steelead/Capstone-Intel-Mood-Light/Project Plan/Team16 project plan.pdf

ID | Task
Mode
Task Name | Duration | Start | Finish | Predecessors | Resource Names
1 | Project Proposal | 10 days | Mon 1/4/16 | Fri 1/15/16
2 | choosing the weight

## sensor

7 days | Sun 1/10/16 | Sun 1/17/16
3 | Buying the parts | 5 days | Mon 1/18/16Fri 1/22/16 | 2
4 | Testing the parts | 0 days | Sat 1/23/16 | Sat 1/23/16 | 3
5 | Interfacing LED's strip

## with arduinu

7 days | Sun 1/31/16 | Sat 2/6/16
6 | - Modify LED strip

## remote to be controlled using arduino

7 days | Sun 2/7/16 | Sat 2/13/16 | 4
7 | Interface pressure

## sensor with arduino

7 days | Sun 2/14/16 | Sat 2/20/16 | 6
8 | - Modify weight

## sensor into a surface the user’s body

7 days | Sun 2/21/16 | Sat 2/27/16 | 7
9 | Code for user

## interface

7 days | Sun 2/28/16 | Sat 3/5/16 | 8
10 | First draft of schematic

## and layout

1 day | Sun 3/6/16 | Sun 3/6/16
11 | Revision of the

## schematic

1 day | Mon 3/7/16 | Mon 3/7/16 | 9
F | S | T | T | S
Jan 3, '16 | Jan 10, '16

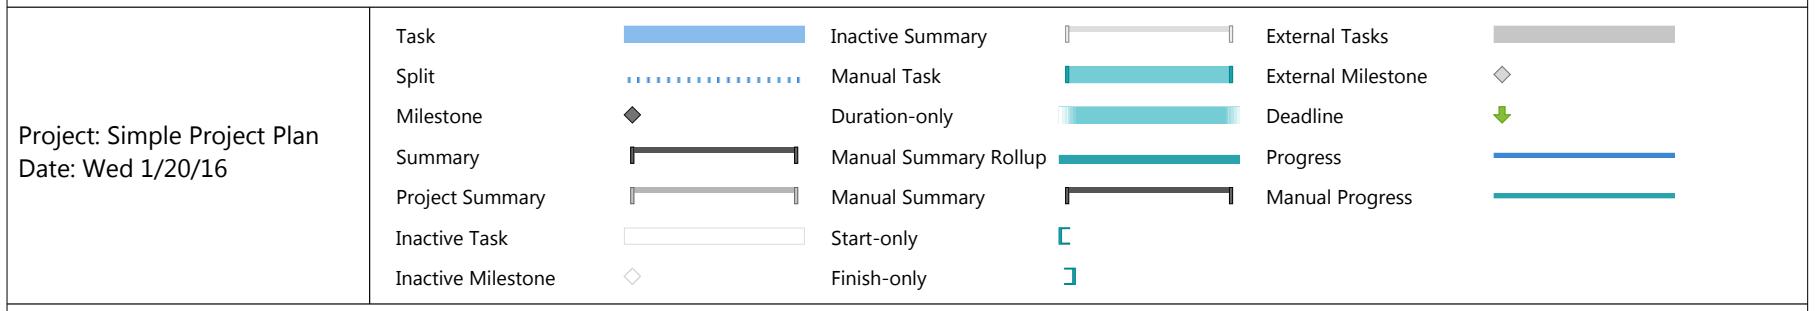
[picture p8: figure]
Task; Split; Milestone; Summary; Project Summary; Inactive Task; Inactive Milestone; Inactive Summary; Manual Task; Duration-only; Manual Summary Rollup; Manual Summary; Start-only; Finish-only; External Tasks; External Milestone; Deadline; Progress; Manual Progress; Project: Simple Project Plan Date: Wed 1/20/16

ID | Task
Mode
Task Name | Duration | Start | Finish | Predecessors | Resource Names
12 | Task 7 | 7 days | Sun 3/27/16 | Sun 4/3/16
13 | Prototype Testing

## and Debuging

| 6 days | Mon 4/4/16 | Mon
4/11/16
14 | Extra features if time
allows (extra sensors,

## bluetooth, nicer user interface, etc.)

| 16 days | Mon
4/18/16

## Sat 5/7/16

15 | - Final prototype

## testing

7 days | Sun 5/8/16 | Sat 5/14/16
16 | Preparing for the
presentation,

## preparing the posters

5 days | Sun 5/15/16 | Thu 5/19/16
17 | Finished and ready

## for Oral Presentation

55 days | Sun 5/22/16 | Thu 8/4/16
F | S | T | T | S
Jan 3, '16 | Jan 10, '16

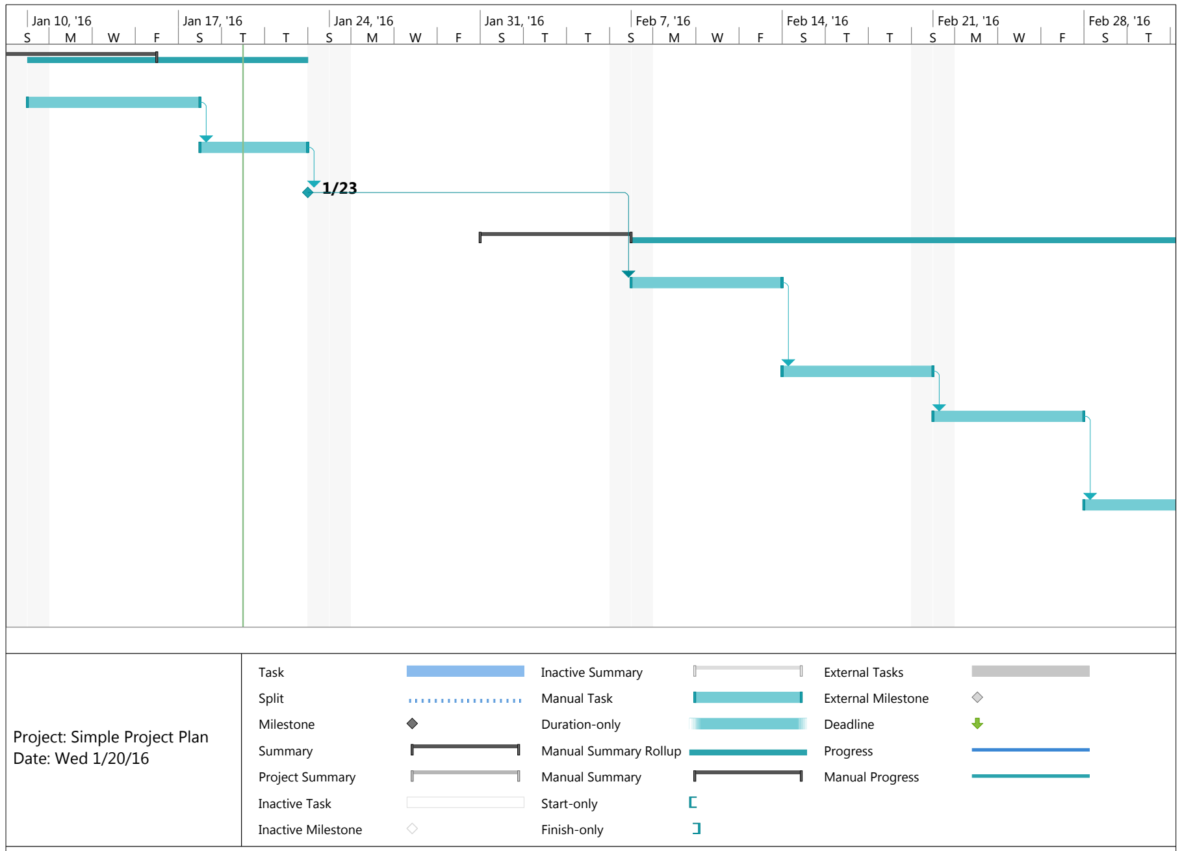
[picture p9: figure]
Jan 10, '16; Jan 17, '16; Jan 24, '16; Jan 31, '16; Feb 7, '16; Feb 14, '16; Feb 21, '16; Feb 28, '16; Task; Split; Milestone; Summary; Project Summary; Inactive Task; Inactive Milestone; Inactive Summary; Manual Task; Duration-only; Manual Summary Rollup; Manual Summary; Start-only; Finish-only; External Tasks; External Milestone; Deadline; Progress; Manual Progress; Project: Simple Project Plan Date: Wed 1/20/16

S | M | W | F | S | T | T | S | M | W | F | S | T | T | S | M | W | F | S | T | T | S | M | W | F | S | T
Jan 10, '16 | Jan 17, '16 | Jan 24, '16 | Jan 31, '16 | Feb 7, '16 | Feb 14, '16 | Feb 21, '16 | Feb 28, '16

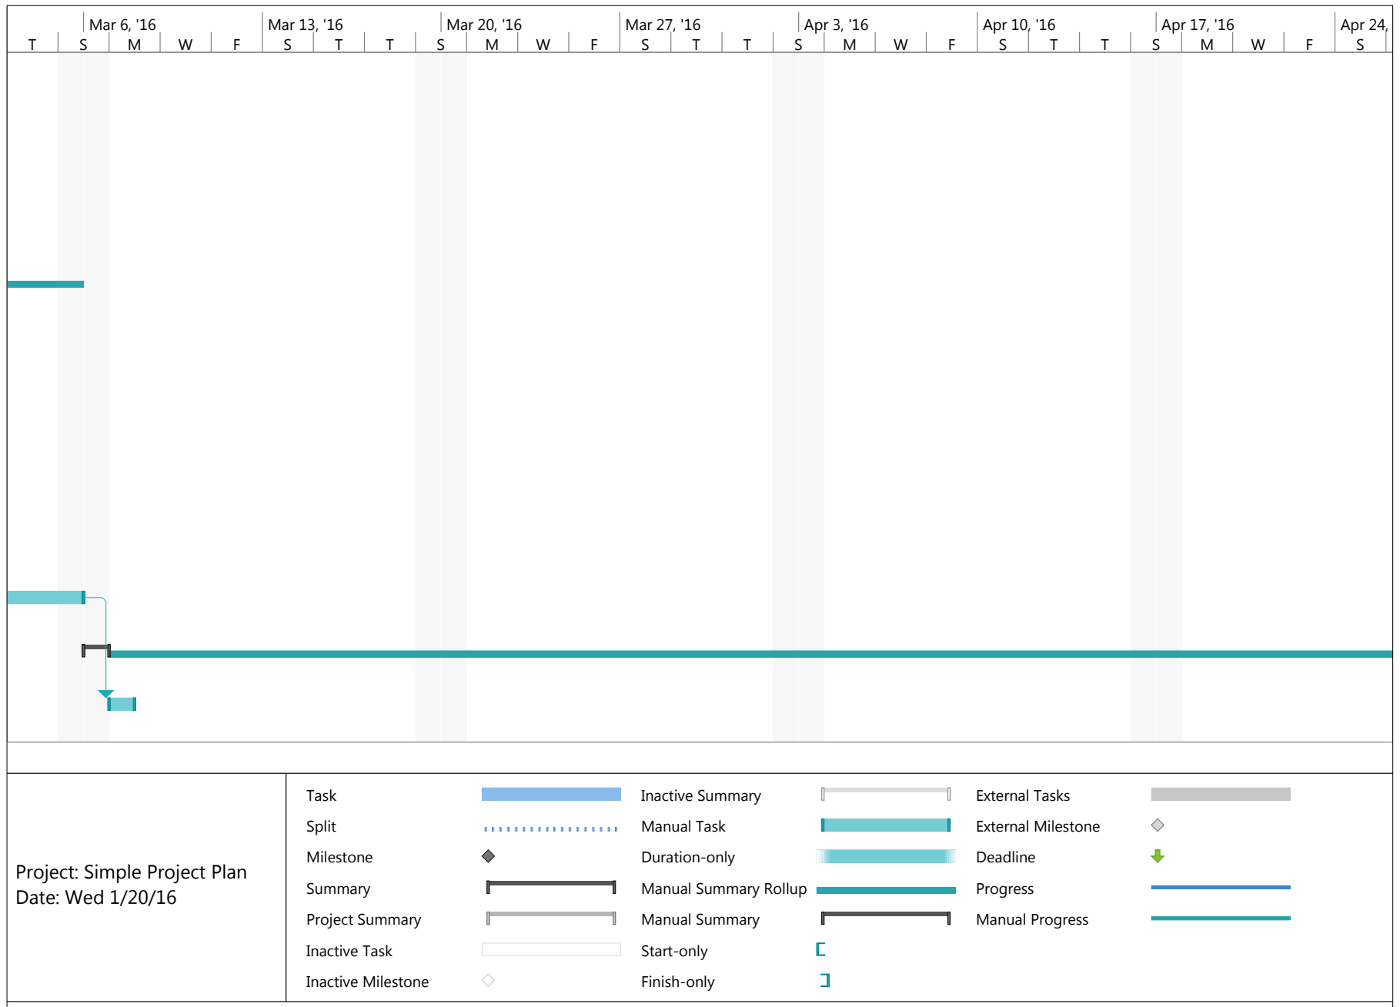
[picture p10: figure]
Mar 6, '16; Mar 13, '16; Mar 20, '16; Mar 27, '16; Apr 3, '16; Apr 10, '16; Apr 17, '16; Apr 24, '16; Task; Split; Milestone; Summary; Project Summary; Inactive Task; Inactive Milestone; Inactive Summary; Manual Task; Duration-only; Manual Summary Rollup; Manual Summary; Start-only; Finish-only; External Tasks; External Milestone; Deadline; Progress; Manual Progress; Project: Simple Project Plan Date: Wed 1/20/16

T | S | M | W | F | S | T | T | S | M | W | F | S | T | T | S | M | W | F | S | T | T | S | M | W | F | S
Mar 6, '16 | Mar 13, '16 | Mar 20, '16 | Mar 27, '16 | Apr 3, '16 | Apr 10, '16 | Apr 17, '16 | Apr 24, '16

T | T | S | M | W | F | S | T | T | S | M | W | F | S | T | T | S | M | W | F | S | T | T | S | M | W | F
Apr 24, '16 | May 1, '16 | May 8, '16 | May 15, '16 | May 22, '16 | May 29, '16 | Jun 5, '16 | Jun 12, '16 | Jun 19, '16

T | T | S | M | W | F | S | T | T | S | M | W | F | S | T | T | S | M | W | F | S | T | T | S | M | W | F
Apr 24, '16 | May 1, '16 | May 8, '16 | May 15, '16 | May 22, '16 | May 29, '16 | Jun 5, '16 | Jun 12, '16 | Jun 19, '16

S | T | T | S | M | W | F | S | T | T | S | M | W | F | S | T | T | S | M | W | F | S | T | T | S | M | W
Jun 19, '16 | Jun 26, '16 | Jul 3, '16 | Jul 10, '16 | Jul 17, '16 | Jul 24, '16 | Jul 31, '16 | Aug 7, '16

S | T | T | S | M | W | F | S | T | T | S | M | W | F | S | T | T | S | M | W | F | S | T | T | S | M | W
Jun 19, '16 | Jun 26, '16 | Jul 3, '16 | Jul 10, '16 | Jul 17, '16 | Jul 24, '16 | Jul 31, '16 | Aug 7, '16
