steelead/Capstone-Intel-Mood-Light/Schematic & Board/CapstoneProject16_latest_board_v1.brd

## EAGLE design Schematic & Board/CapstoneProject16_latest_board_v1.brd (2016-05-30, an earlier design)

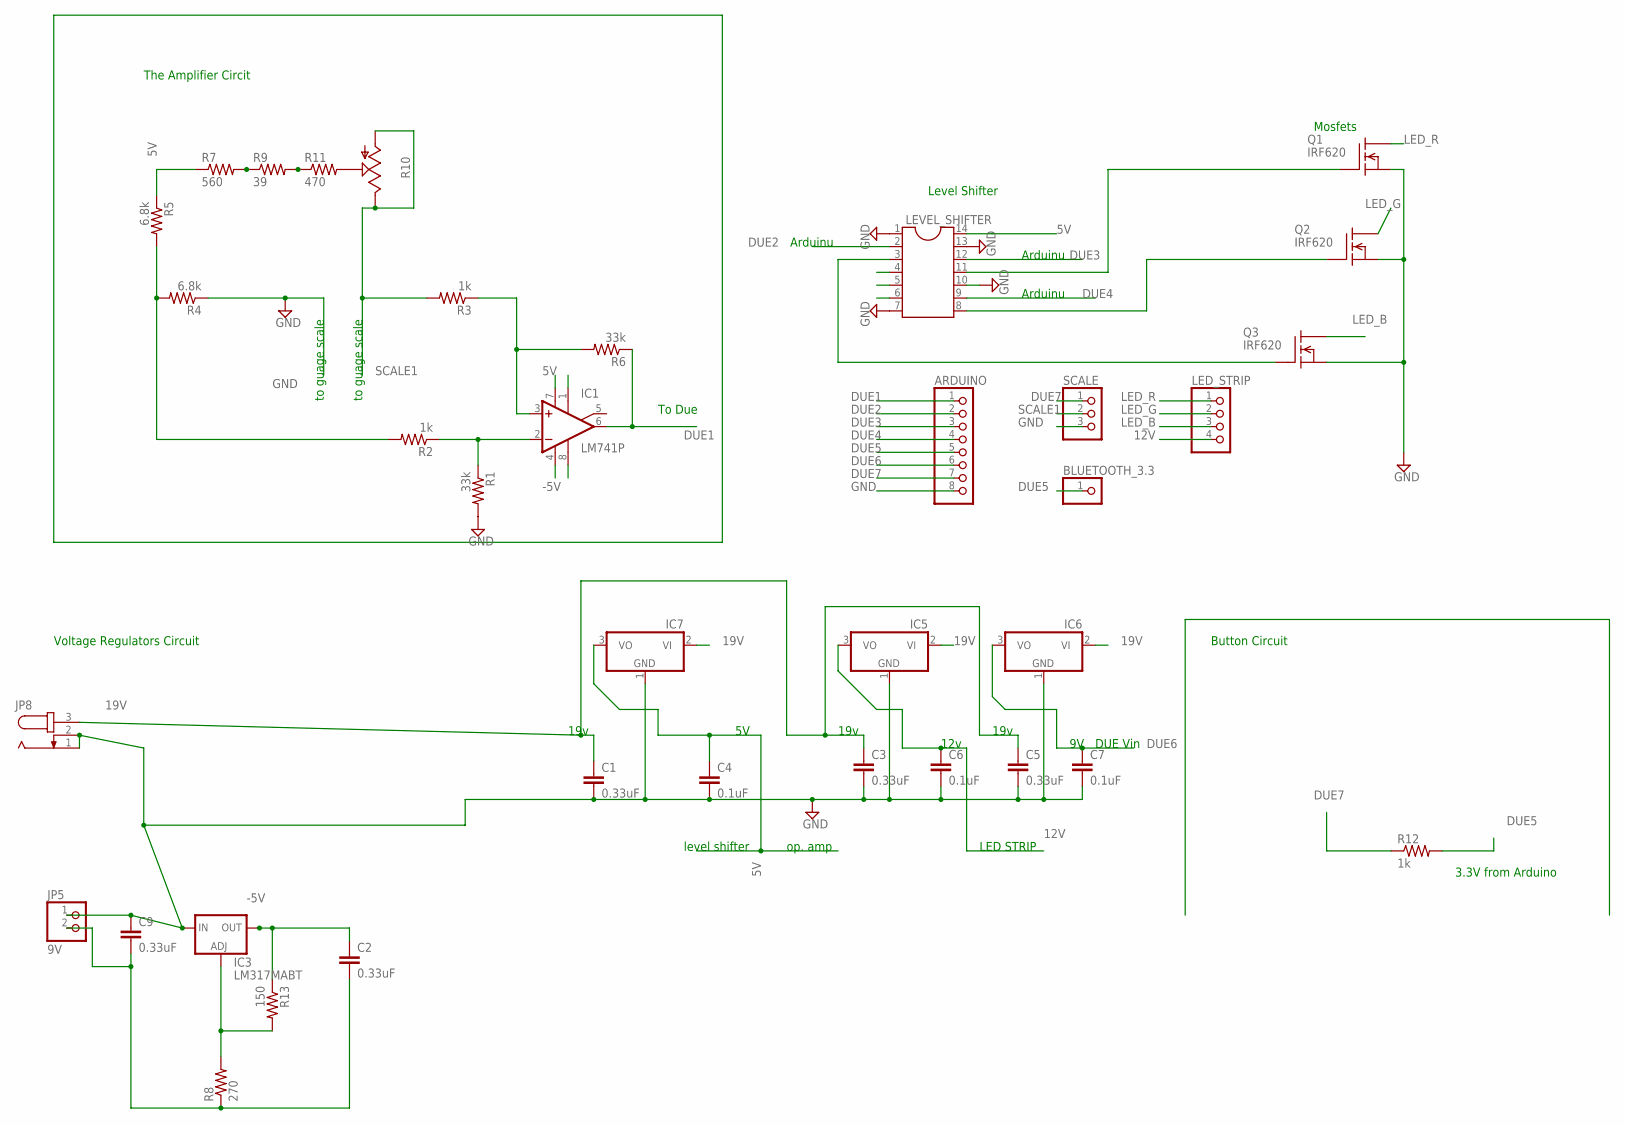
[picture p11: schematic CapstoneProject16_latest_board_v1.sch]

Parts:
ARDUINO: PINHD-1X8; 1X08
BLUETOOTH_3.3: PINHD-1X1; 1X01
C1, C2, C3, C5, C9: 0.33uF; C2.5-3
C4, C6, C7: 0.1uF; C2.5-3
IC1: LM741P; DIL08
IC3: LM317MABT; TO220L1
IC5, IC6: 7905T; TO220H
IC7: 79L05Z; TO92
JP5: 9V; 1X02
JP8: JACK-PLUG1; SPC4078
LED_STRIP: PINHD-1X4; 1X04
LEVEL_SHIFTER: DIL14
Q1, Q2, Q3: IRF620; TO220
R1, R6: 33k; 0204/7
R2, R3, R12: 1k; 0204/7
R4, R5: 6.8k; 0204/7
R7: 560; 0204/7
R8: 270; 0204/7
R9: 39; 0204/7
R10: TRIM_US-S63P; S63P
R11: 470; 0204/7
R13: 150; 0204/7
SCALE: PINHD-1X3; 1X03

Connections:
5V: C4.1, IC1.7 (V+), IC7.3 (VO), LEVEL_SHIFTER.14, R5.1, R7.1
12V: C6.1, IC5.3 (VO), LED_STRIP.4
19V: C1.1, C3.1, C5.1, IC5.2 (VI), IC6.2 (VI), IC7.2 (VI), JP8.3
-5V: C2.1, IC1.4 (V-), IC3.2 (OUT), R13.1
DUE1: ARDUINO.1, IC1.6 (OUT), R6.1
DUE2: ARDUINO.2, LEVEL_SHIFTER.2
DUE3: ARDUINO.3, LEVEL_SHIFTER.12
DUE4: ARDUINO.4, LEVEL_SHIFTER.9
DUE5: ARDUINO.5, BLUETOOTH_3.3.1, R12.2
DUE6: ARDUINO.6, C7.1, IC6.3 (VO)
DUE7: ARDUINO.7, R12.1, SCALE.1
GND: ARDUINO.8, C1.2, C3.2, C4.2, C5.2, C6.2, C7.2, C9.1, IC3.3 (IN), IC5.1 (GND), IC6.1 (GND), IC7.1 (GND), JP5.1, JP8.1, JP8.2, LEVEL_SHIFTER.1, LEVEL_SHIFTER.7, LEVEL_SHIFTER.10, LEVEL_SHIFTER.13, Q1.3 (S), Q2.3 (S), Q3.3 (S), R1.2, R4.1, SCALE.3
LED_B: LED_STRIP.3, Q3.2 (D)
LED_G: LED_STRIP.2, Q2.2 (D)
LED_R: LED_STRIP.1, Q1.2 (D)
unnamed: R2.2, R4.2, R5.2
unnamed: IC1.2 (-IN), R1.1, R2.1
unnamed: IC1.3 (+IN), R3.1, R6.2
unnamed: R10.S, R11.2
unnamed: R7.2, R9.1
unnamed: C2.2, C9.2, JP5.2, R8.1
unnamed: IC3.1 (ADJ), R8.2, R13.2
unnamed: R9.2, R11.1
unnamed: LEVEL_SHIFTER.11, Q1.1 (G)
unnamed: LEVEL_SHIFTER.8, Q2.1 (G)
unnamed: LEVEL_SHIFTER.3, Q3.1 (G)
SCALE1: R3.2, R10.A, R10.E, SCALE.2

Notes on the sheet:
The Amplifier Circit
Voltage Regulators Circuit
To Due
to guage scale
Arduinu
Button Circuit
19v
op. amp
level shifter
DUE Vin
12v
LED STRIP
Level Shifter
Mosfets
3.3V from Arduino

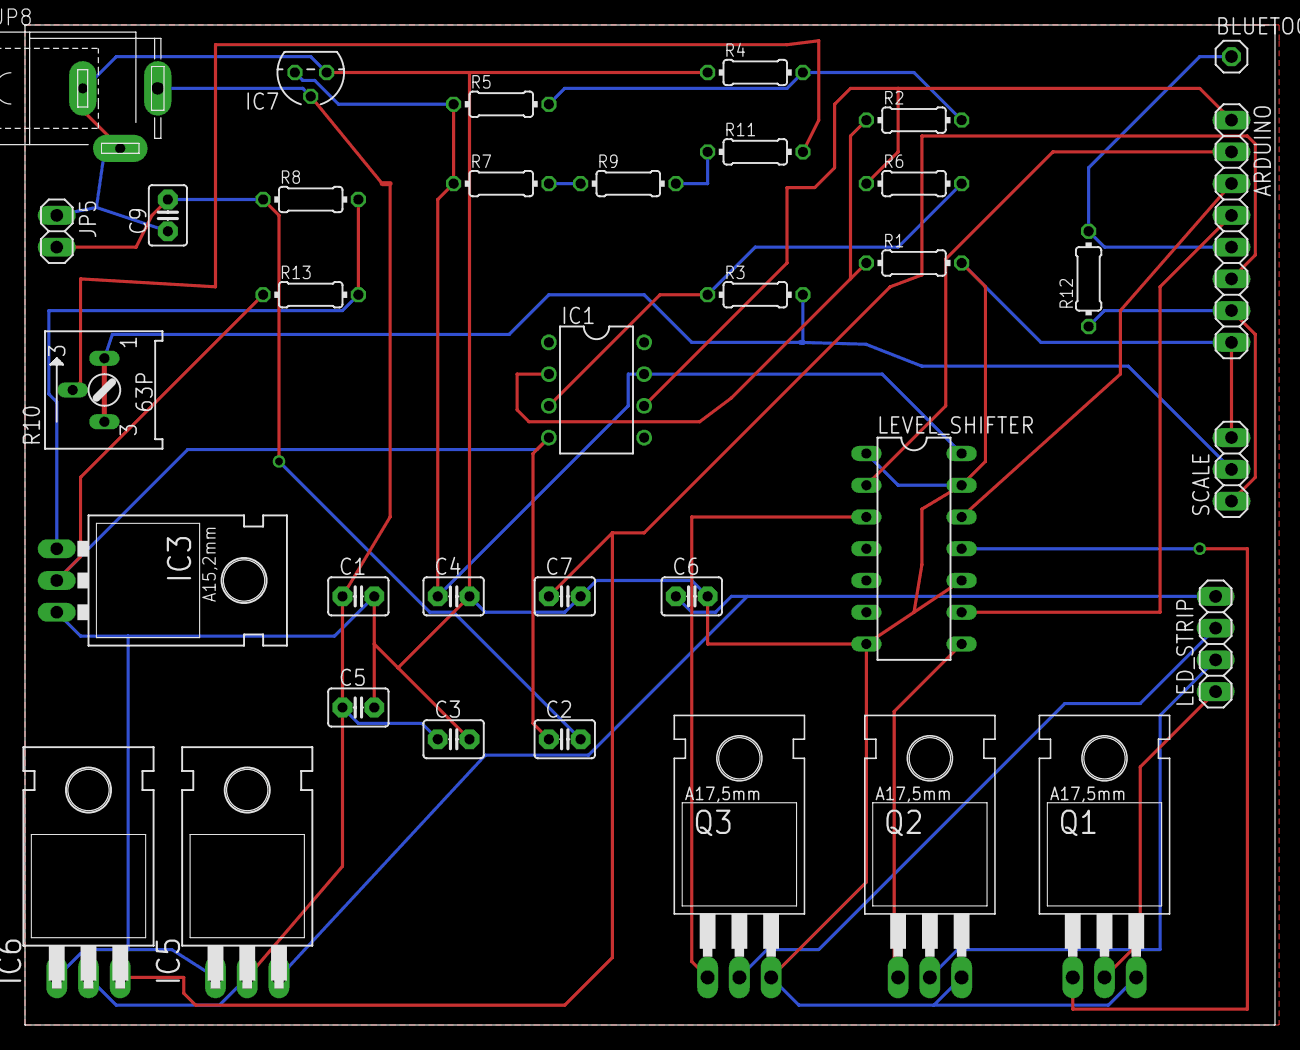
[picture p12: board CapstoneProject16_latest_board_v1.brd from above]

Board: 2 copper layers, 100.0 x 80.0 mm, 36 parts (0 on the bottom side), 27 nets.
