steelead/Capstone-Intel-Mood-Light/testStringSearch/testStringSearch.ino

void setup() {
  // put your setup code here, to run once:
  char *str = "Mother Father Gentleman";
  char search = 'e';

  char *index;

  Serial.begin(9600);

  Serial.print("looking for '");
  Serial.print(search);
  Serial.print("' in ");
  Serial.print(str);
  Serial.println("'.");

  index = strchr(str,(int)search);
  while(index != NULL)
  {
    Serial.print("found at ");
    Serial.println(index-str+1);
    index = strchr(index+1,(int)search);
  }

  String mystr = "Ahhhh I'm Tilting!";
  char myarray[50];
  mystr.toCharArray(myarray, 50);
  Serial.print("string = ");
  Serial.println(mystr);
  Serial.print("char array = ");
  Serial.println(myarray);

}

void loop() {
  // put your main code here, to run repeatedly:

}
