steelead/Capstone-Intel-Mood-Light/(commit log)

2016-02-03 added test load cell arduino sketch
2016-03-06 uses button
2016-04-12 code for merging LED Strip code and Weight sensor
2016-05-16 commit includes new board and schematic plus some updated code
    [CapstoneProject16.brd, CapstoneProject16.sch]
2016-05-19 Small test arduino functions to test different components of the new features being added to the main (complete) program
2016-05-20 final code for arduino and pc program for connecting to arduino, not quite finished yet
2016-05-24 Added new test files to test different components that will be integrated into the final code.
    testNewWeight.ino is the new method of getting the weight where when someone steps on the scale we take several samples and compare them, making sure that the values are constant (within some error range), and once we get a consistent value, we save that, and wait for the user to step off the scale before exiting the loop.
    The second script testStringSearch.ino is just some code to be able to check a character array string and search for a character within it, and return the index.
    [testNewWeight.ino, testStringSearch.ino]
2016-05-24 board and schematic final version
    [CapstoneProject16_latest.sch, CapstoneProject16_latest_board_v1.brd, CapstoneProject16_latest_board_v1.sch, CapstoneProject16_latest_board_v2.brd, CapstoneProject16_latest_board_v2.sch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]
2016-05-30 updated final code for user interface and arduino. Allows 3 main methods of user interface: add, remove, and modifing of user profiles (grouping of name, color, and weight).
2016-05-31 updated final code, fixed run errors, first tested version
    [computer2arduino.py, finalCode.ino]
